Burtorustum/Independent-Study/README.md

# Independent Study
Repository for Linda and Rob's independent study into the Spyndra open source robot.
See the fork for more info (one day).
