Burtorustum/Independent-Study/PDFs:Instructions/spyndra electronics.png

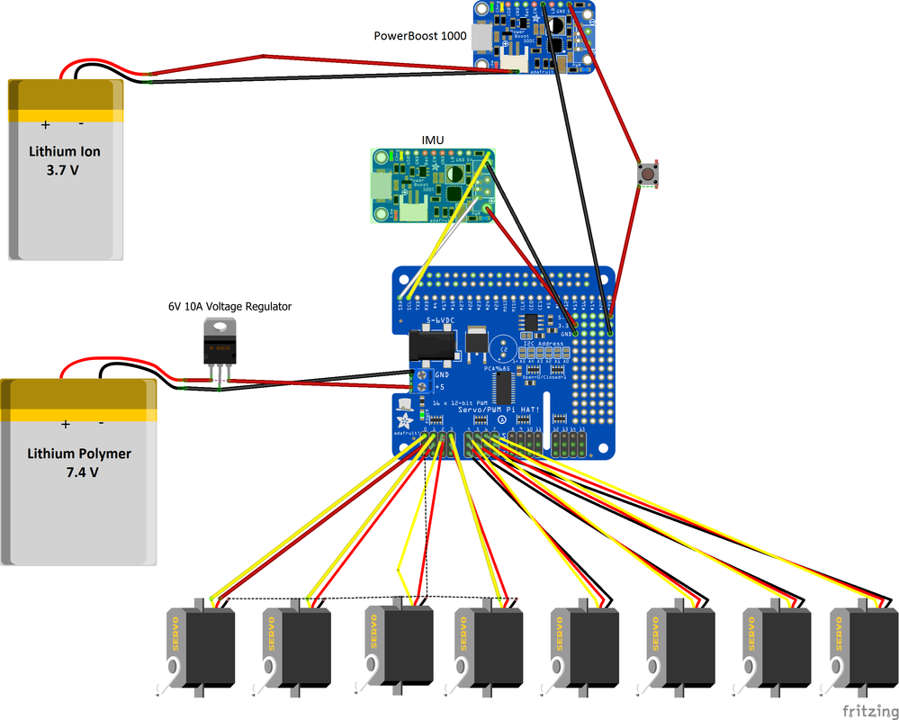
PDFs:Instructions/spyndra electronics.png
