Burtorustum/Independent-Study/CAD-Files/Femur.stl

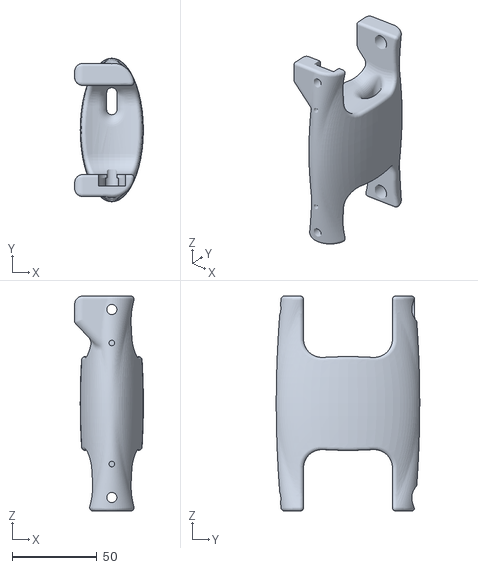
[picture p23: CAD file, 2017-09-25]
CAD-Files/Femur.stl
40.7 x 84.8 x 127.0
