Burtorustum/Independent-Study/CAD-Files/Chassis.stl

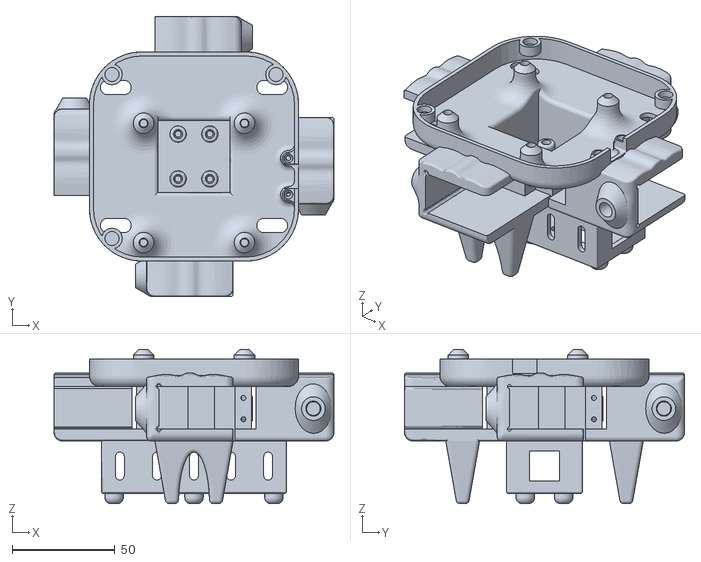
[picture p24: CAD file, 2017-09-25]
CAD-Files/Chassis.stl
136.0 x 136.0 x 75.0
