Burtorustum/Independent-Study/CAD-Files/FemurJig.stl

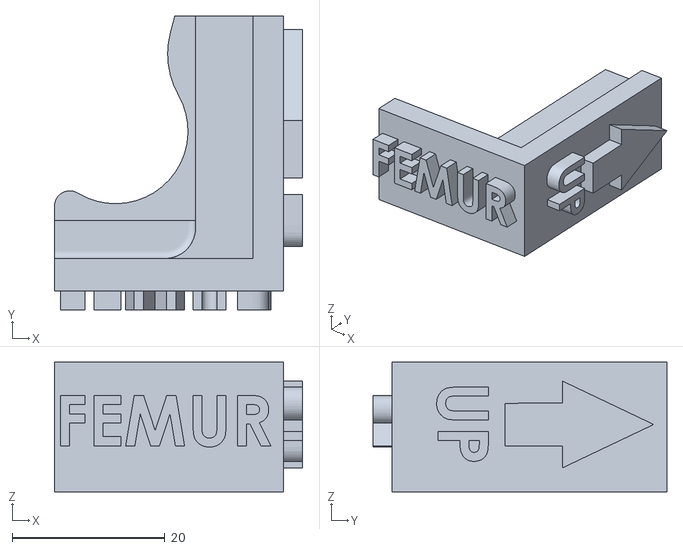
[picture p25: CAD file, 2017-09-25]
CAD-Files/FemurJig.stl
32.5 x 38.5 x 17.0
