Burtorustum/Independent-Study/CAD-Files/Tibia.stl

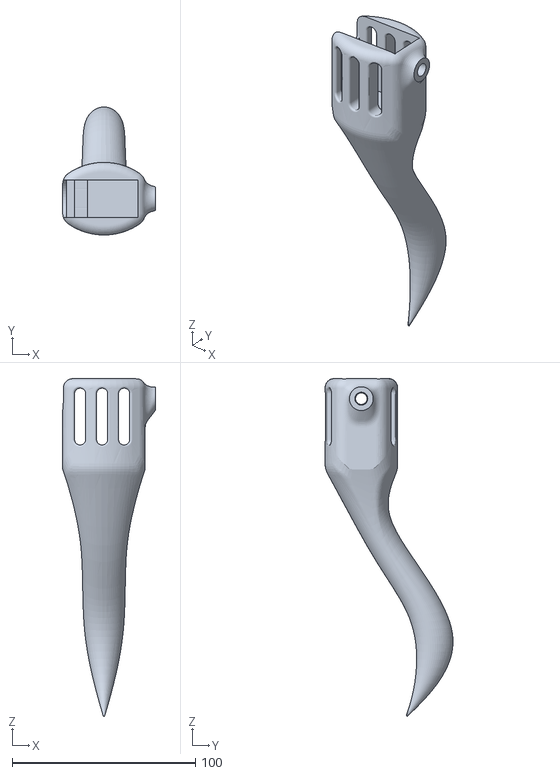
[picture p26: CAD file, 2017-09-25]
CAD-Files/Tibia.stl
50.5 x 69.8 x 184.4
