Burtorustum/Independent-Study/CAD-Files/TibiaJig.stl

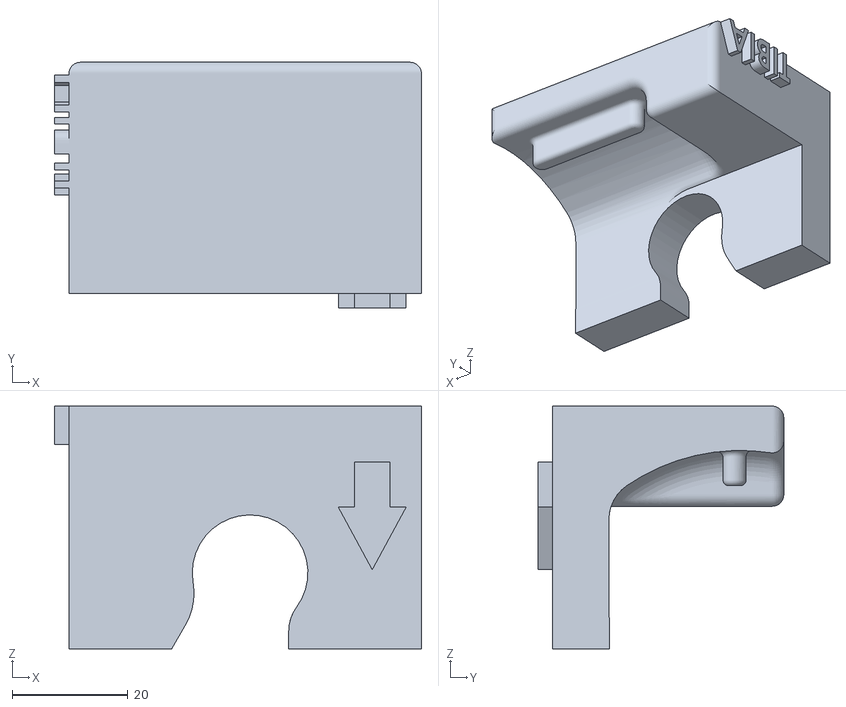
[picture p27: CAD file, 2017-09-25]
CAD-Files/TibiaJig.stl
63.5 x 42.5 x 42.0
