Burtorustum/Independent-Study/CAD-Files/ChassisCover.stl

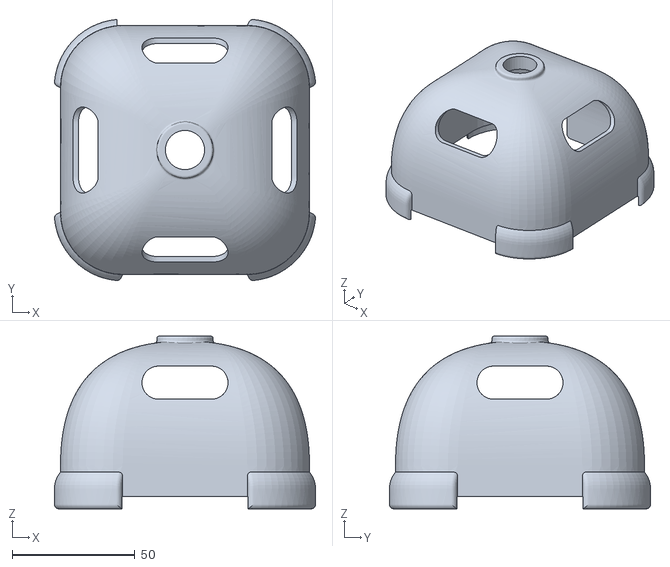
[picture p28: CAD file, 2017-09-18]
CAD-Files/ChassisCover.stl
106.5 x 106.5 x 70.5
