Burtorustum/Independent-Study/(commit log)

2017-09-18 Added CAD files
    [ChassisCover.stl]
2017-09-26 Cleaned repo.. renamed Chasis to Chassis...
    [Chassis.stl, ChassisCover.stl]
2017-12-28 Updated directories and added driver installer.
2017-12-28 Renamed pdf folder and added IMU datasheet
2017-12-28 Added driver installer and servo hat controller classes to our repository
2017-12-28 removed old driver installer folder as it only had one file in it.
2017-12-28 Added BNO055 IMU python file
2017-12-28 Removed useless stuff from Servo hat controller folder -- we can update manually from their repository if they ever update it
2017-12-28 added datasheet for servohat
